Panda381/ATX80/www/img/atx80_5_m.jpg

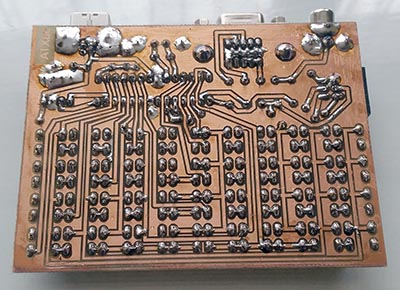
www/img/atx80_5_m.jpg
