Panda381/ATX80/www/img/atx80_8.jpg

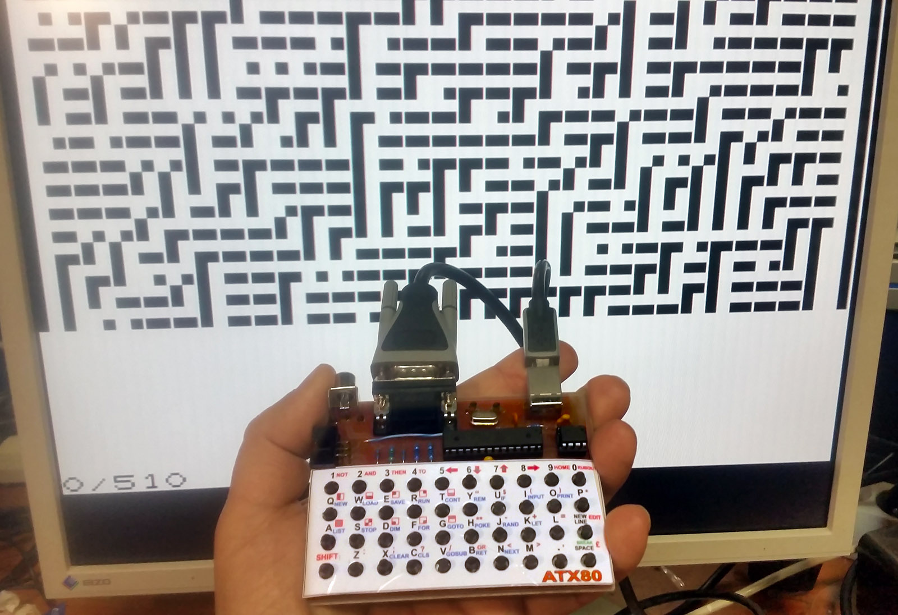
www/img/atx80_8.jpg
