Panda381/ATX80/png/ATX80_bottom.png

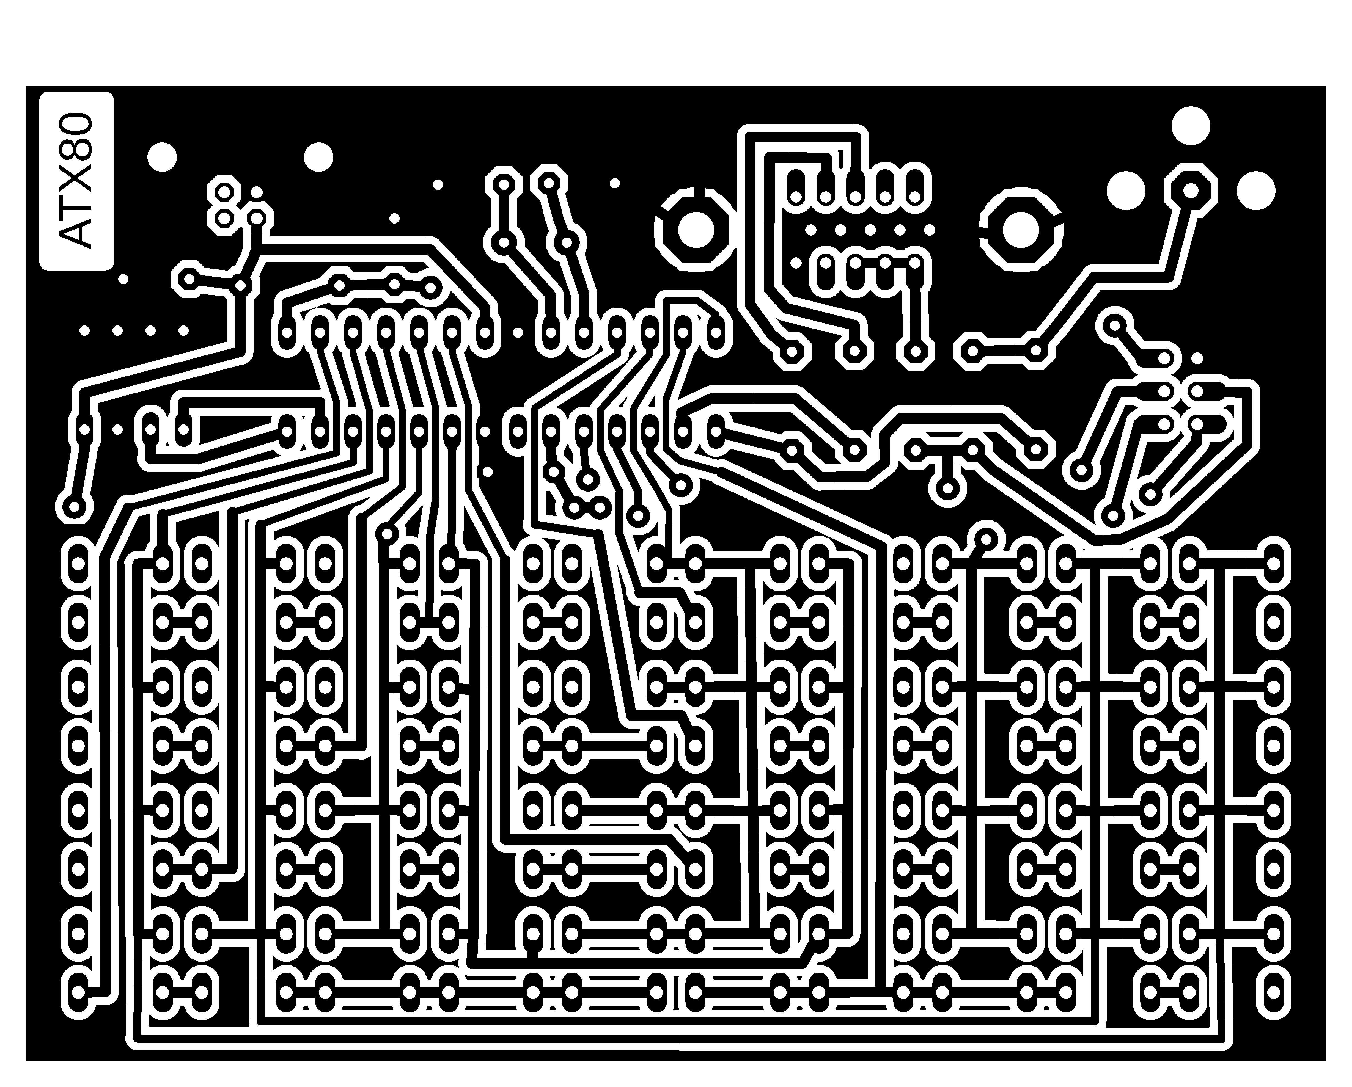
png/ATX80_bottom.png
