Panda381/ATX80/png/ATX80_diagram.png

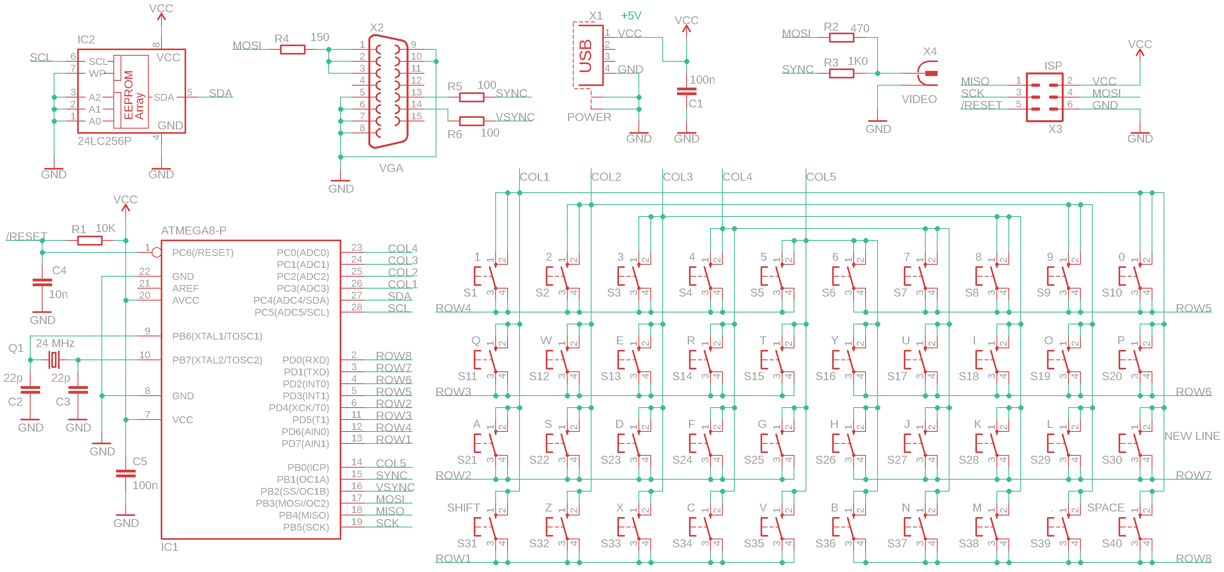
png/ATX80_diagram.png
