Panda381/ATX80/png/ATX80_doc.png

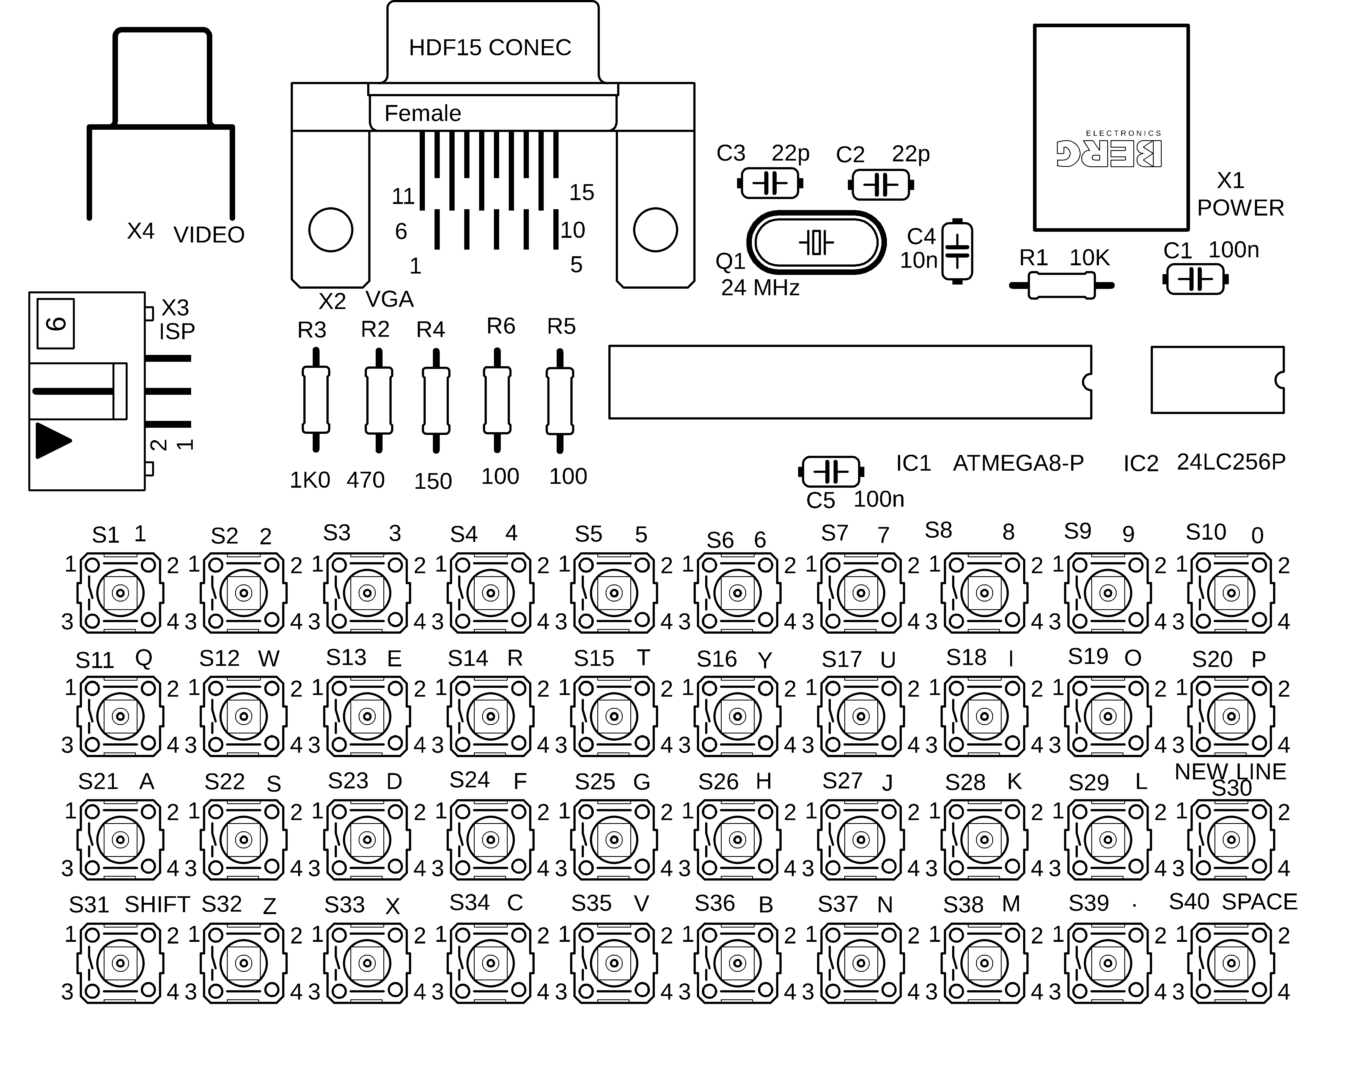
png/ATX80_doc.png
