Panda381/ATX80/png/ATX80_label.png

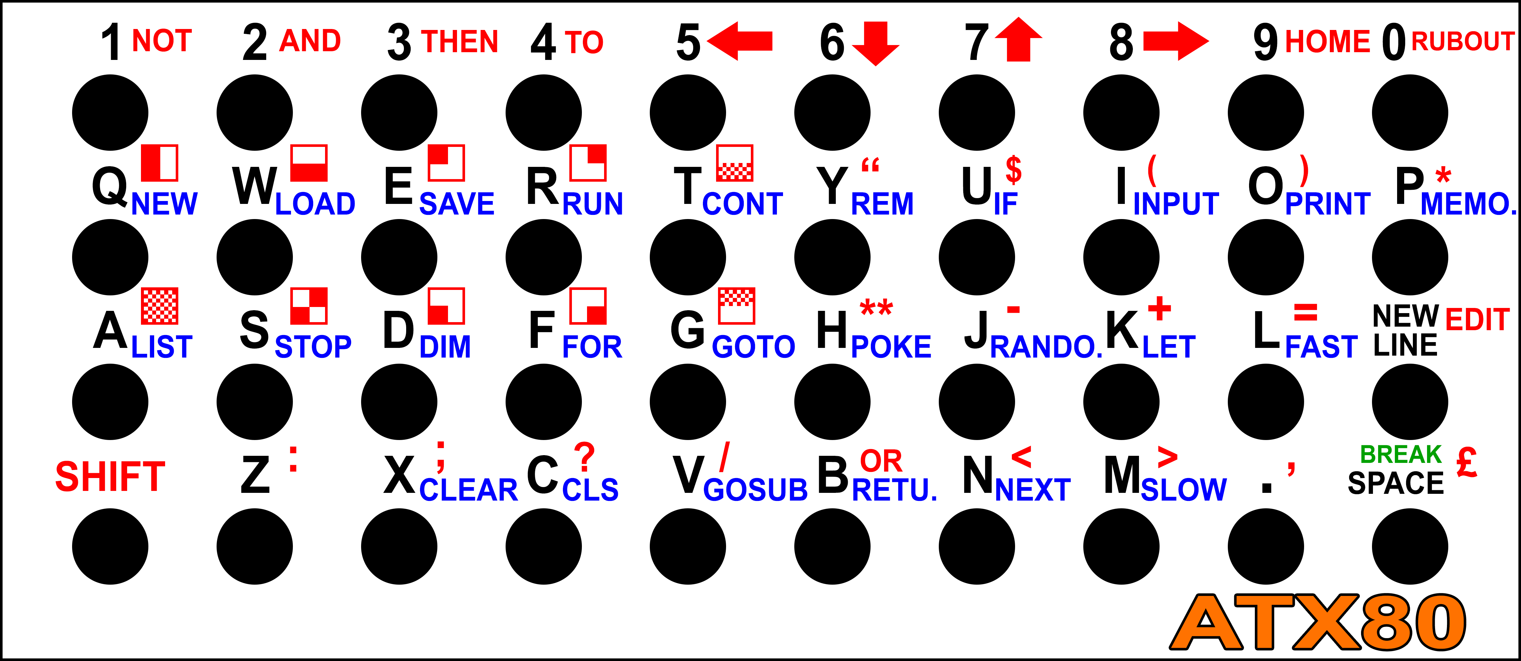
png/ATX80_label.png
