Panda381/ATX80/png/ATX80_mounte.jpg

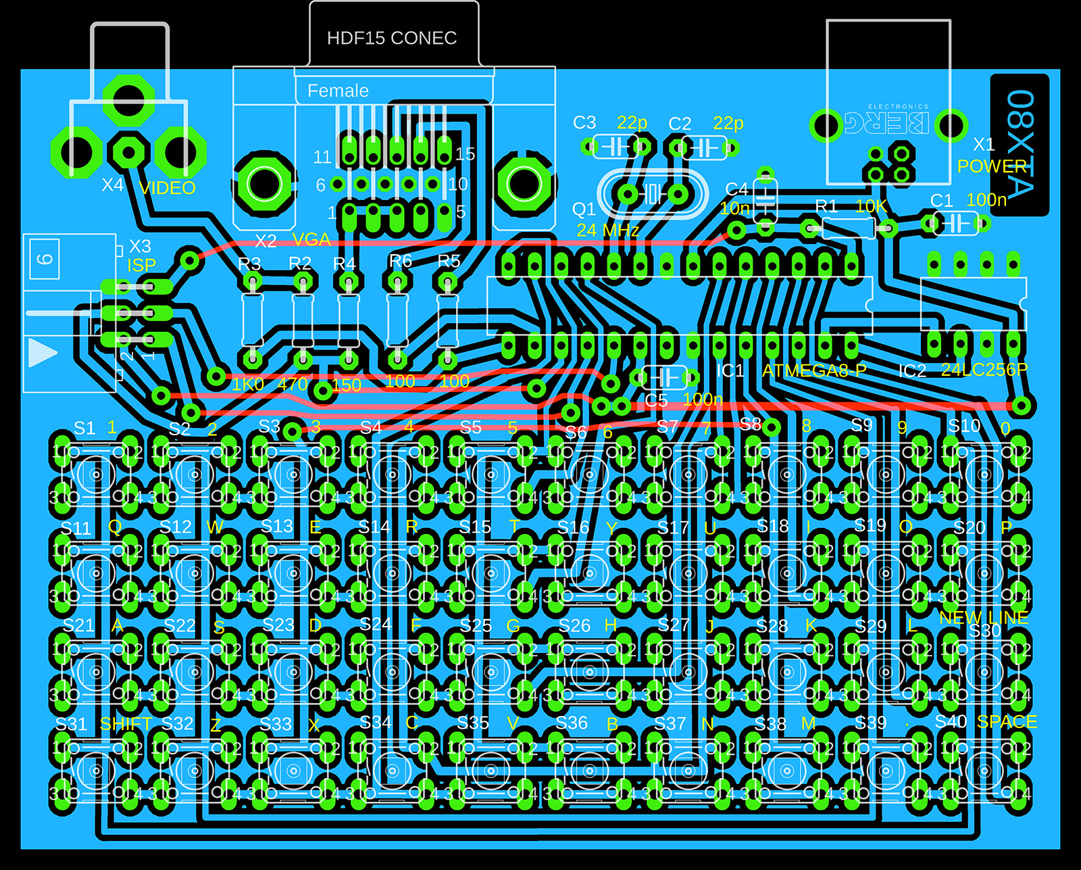
png/ATX80_mounte.jpg
