Panda381/ATX80/png/ATX80_names.png

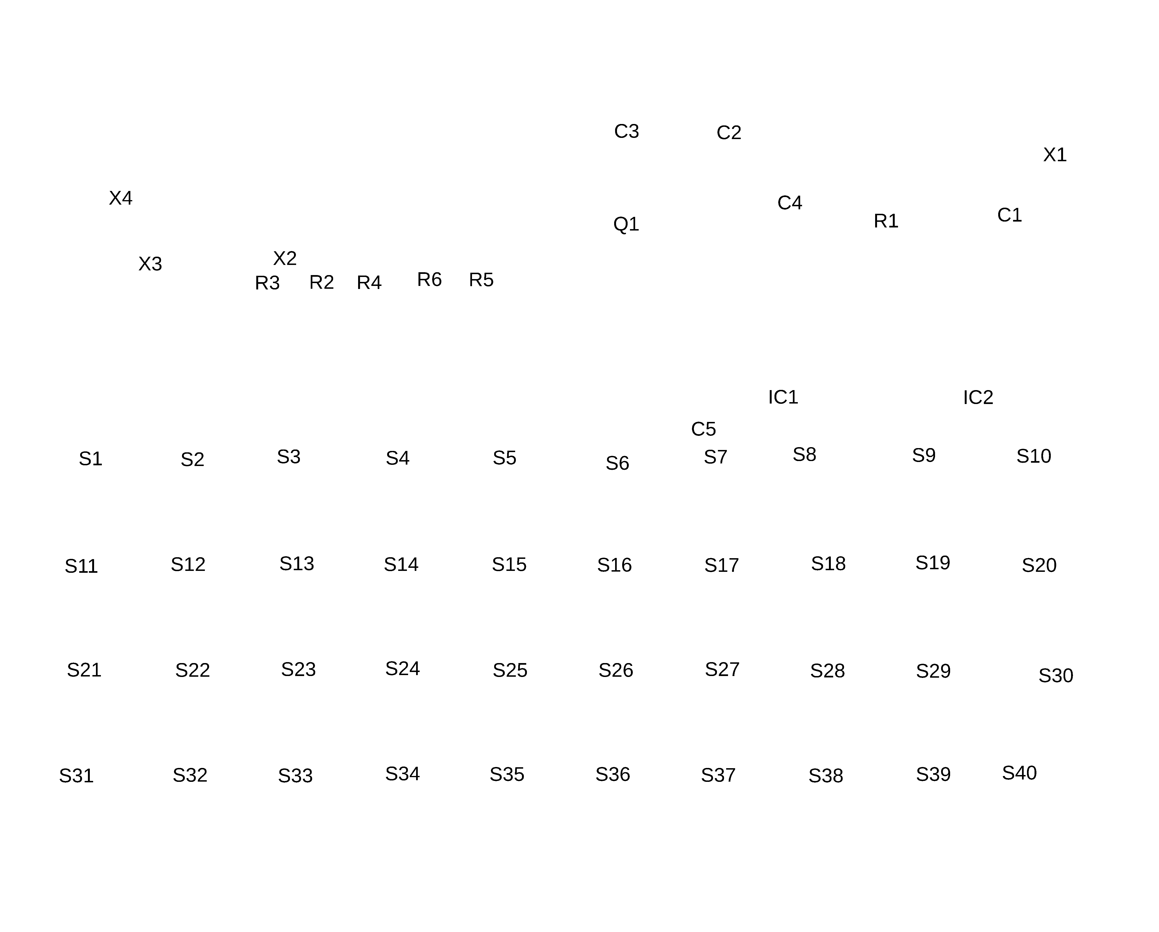
png/ATX80_names.png
