Panda381/ATX80/png/ATX80_pads.png

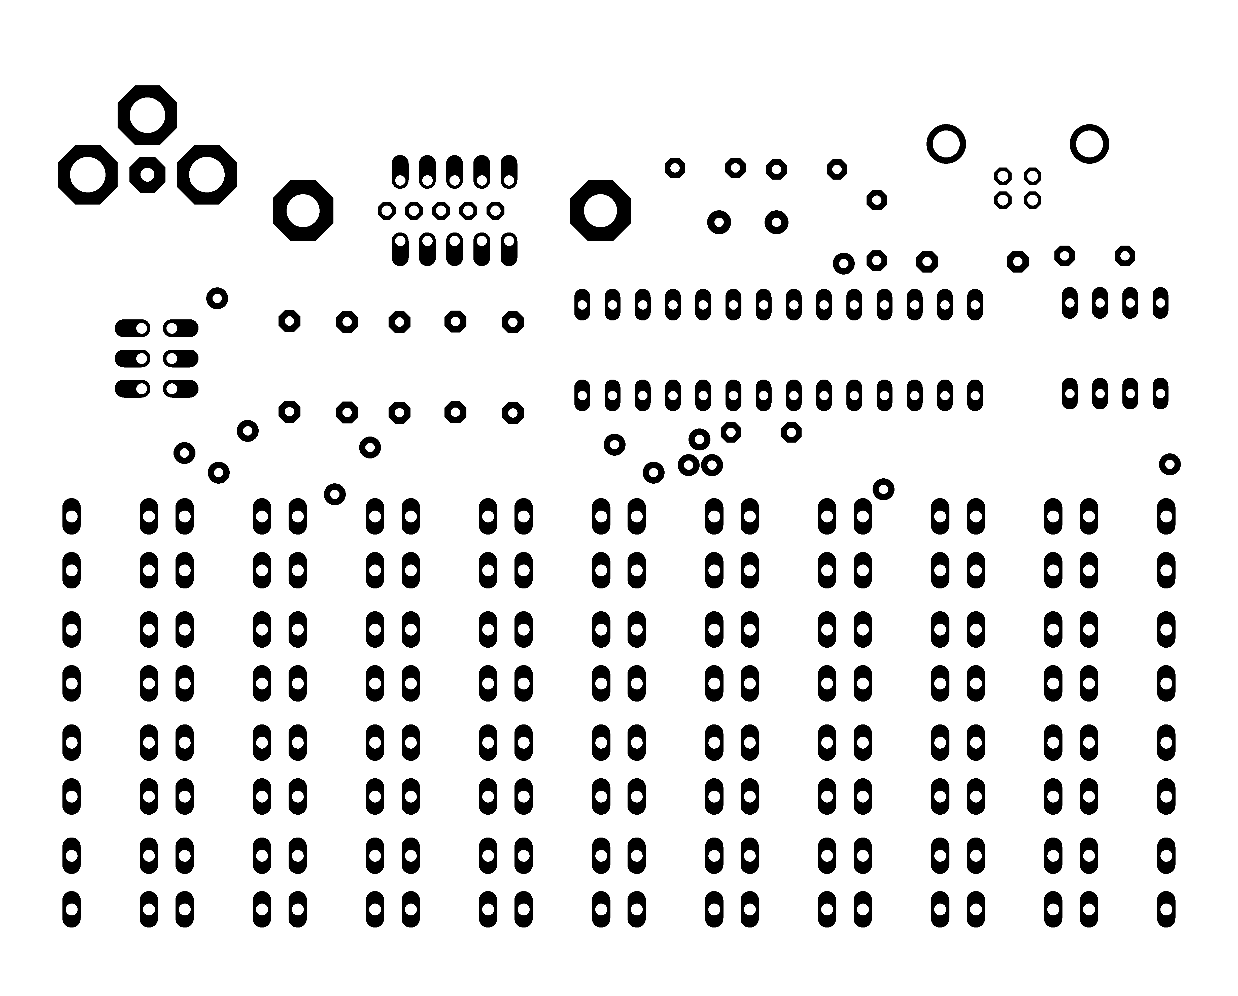
png/ATX80_pads.png
