Panda381/ATX80/png/ATX80_route.png

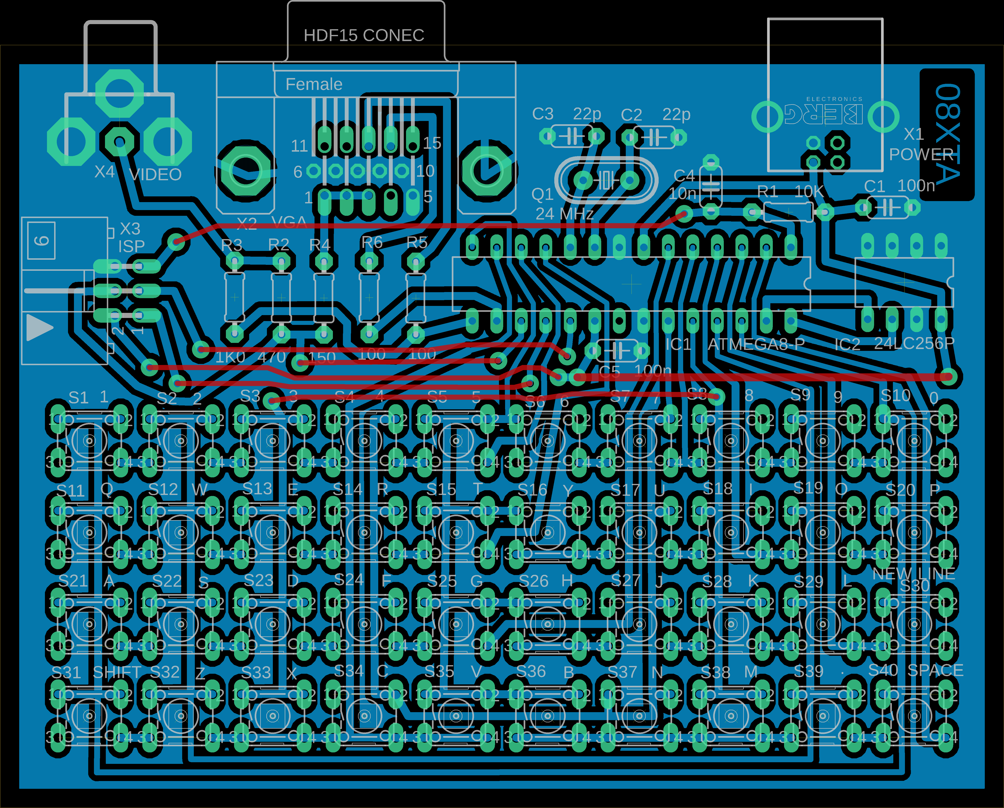
png/ATX80_route.png
