Panda381/ATX80/png/ATX80_template2.png

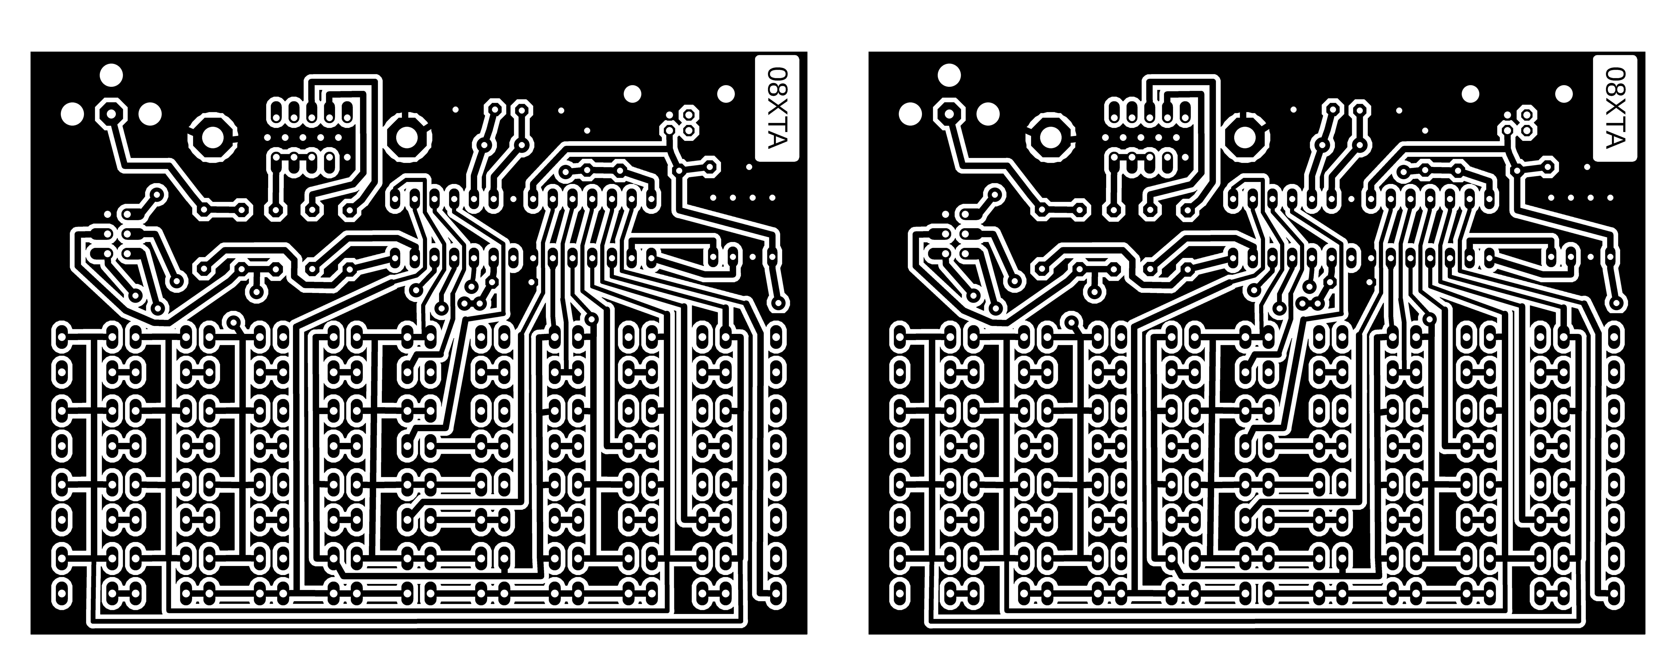
png/ATX80_template2.png
