Panda381/ATX80/png/ATX80_template.png

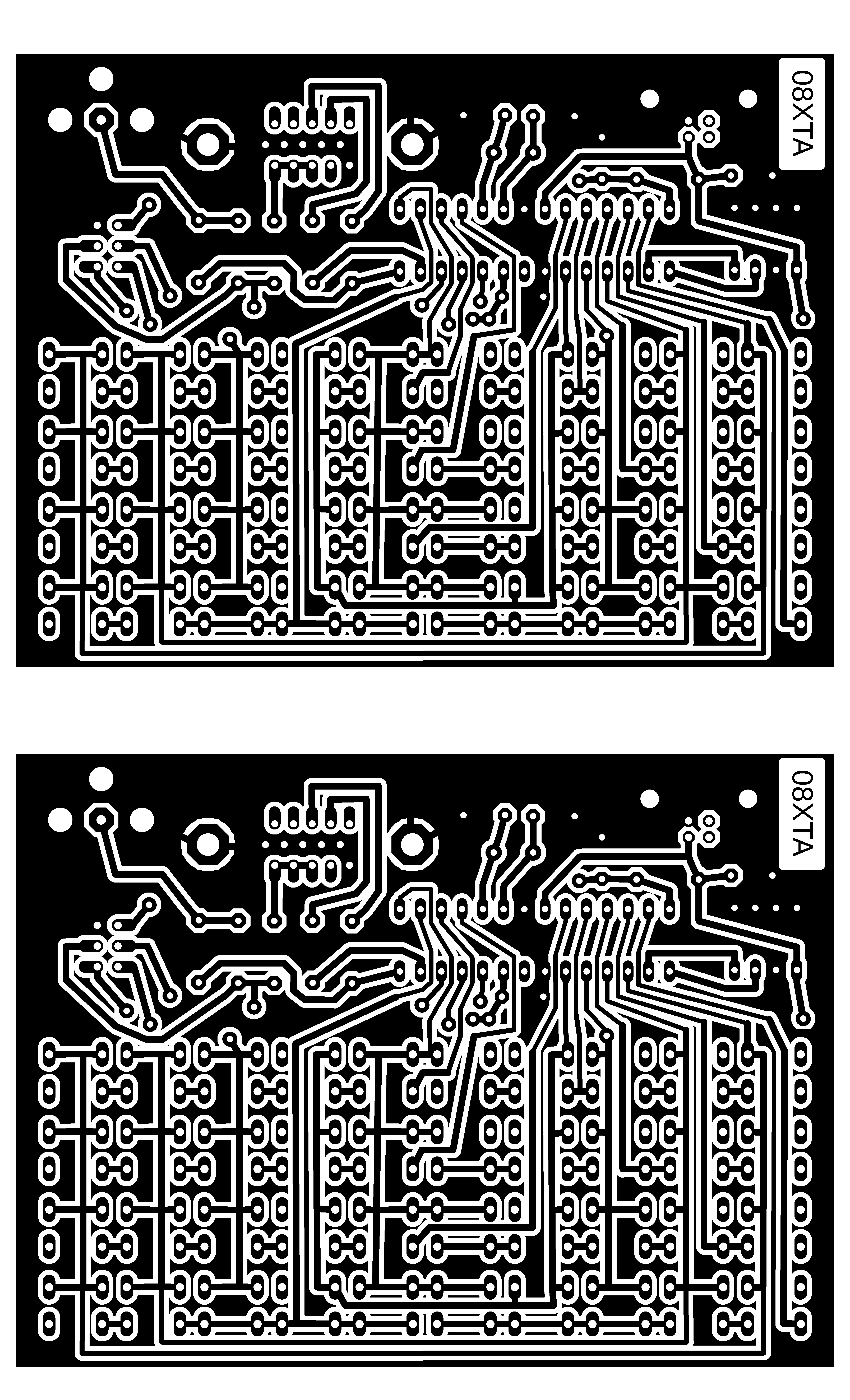
png/ATX80_template.png
