Panda381/ATX80/png/ATX80_top.png

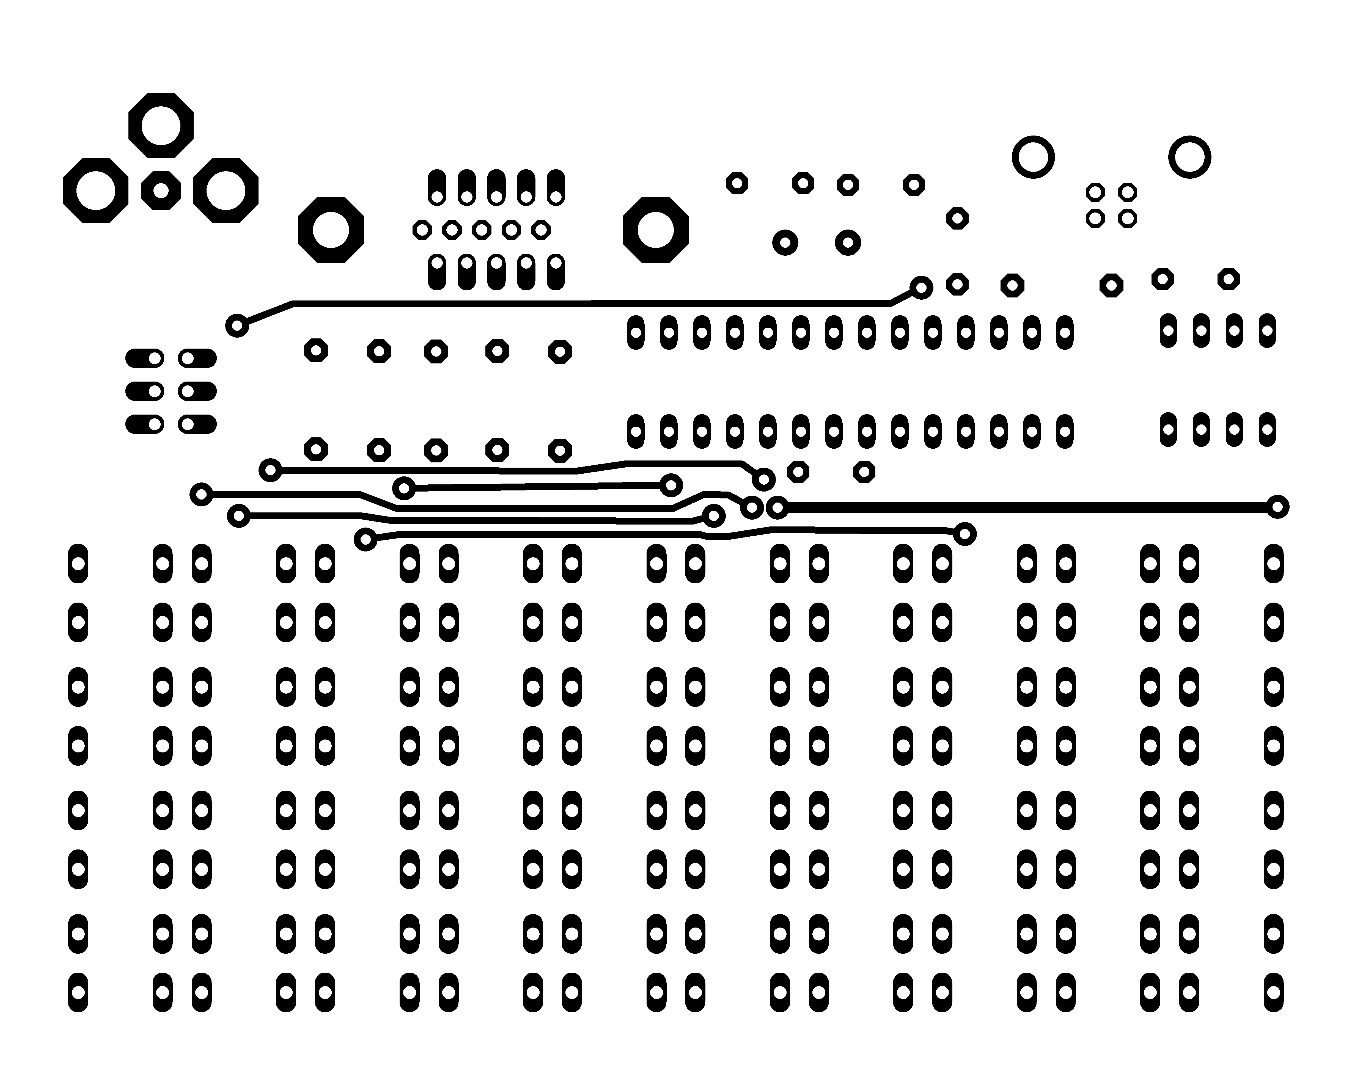
png/ATX80_top.png
