Panda381/ATX80/png/ATX80_values.png

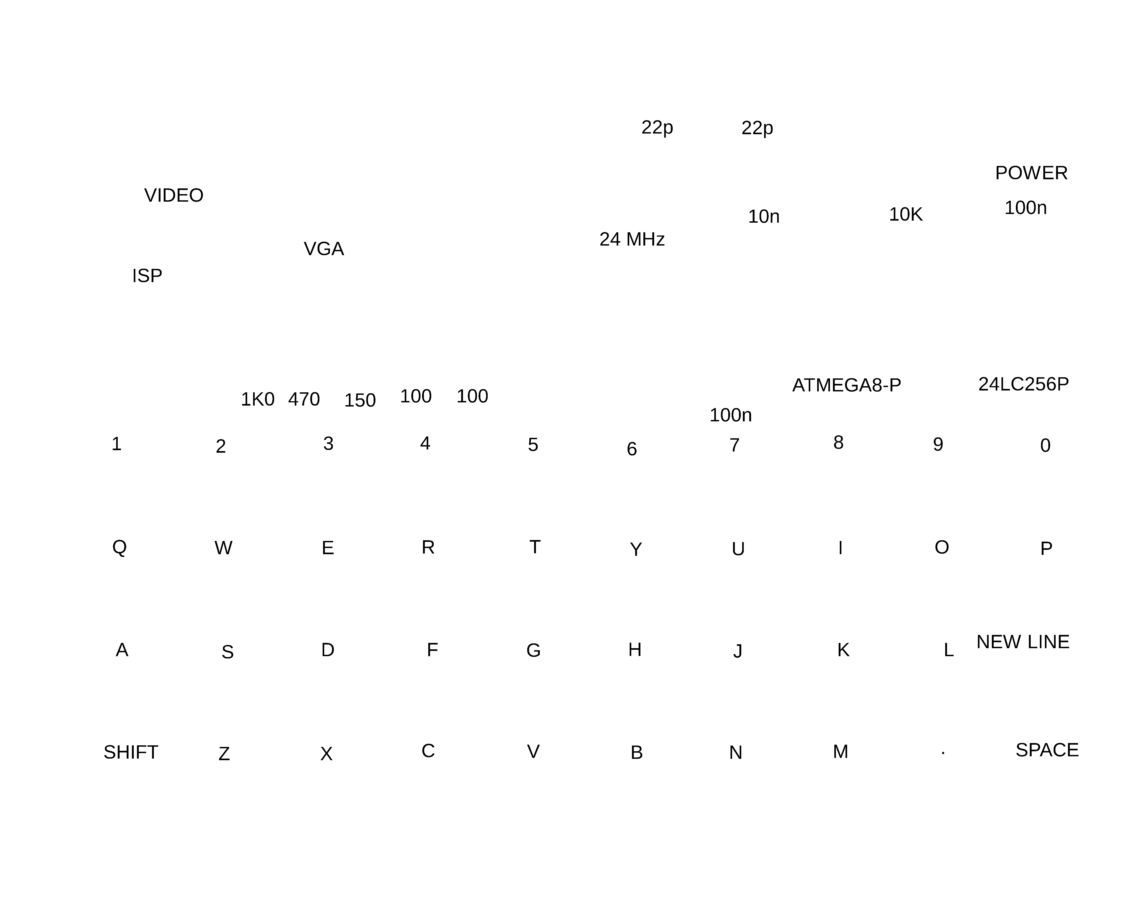
png/ATX80_values.png
