Panda381/ATX80/www/img/atx80_0_m.jpg

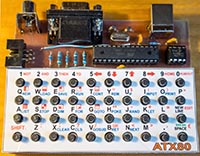
www/img/atx80_0_m.jpg
