Panda381/ATX80/www/img/atx80_2.jpg

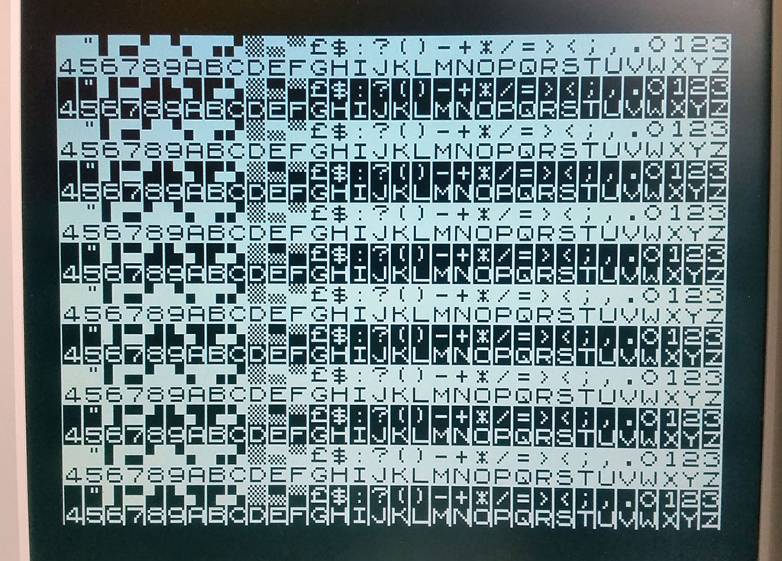
www/img/atx80_2.jpg
