Panda381/ATX80/www/img/atx80_3.jpg

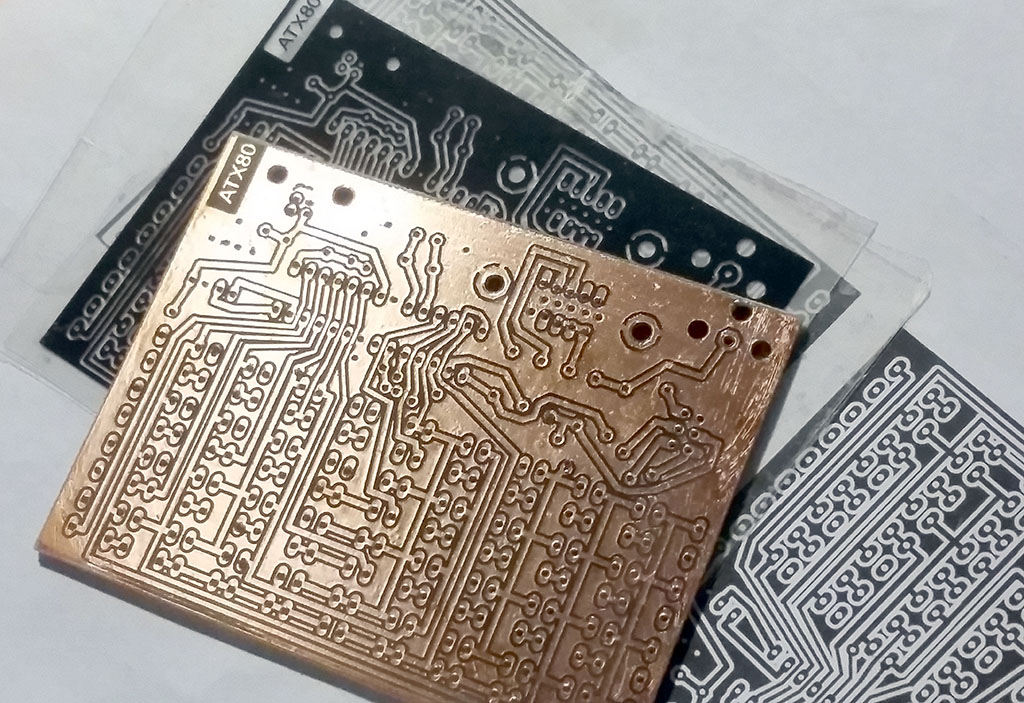
www/img/atx80_3.jpg
