Panda381/ATX80/www/img/atx80_4.jpg

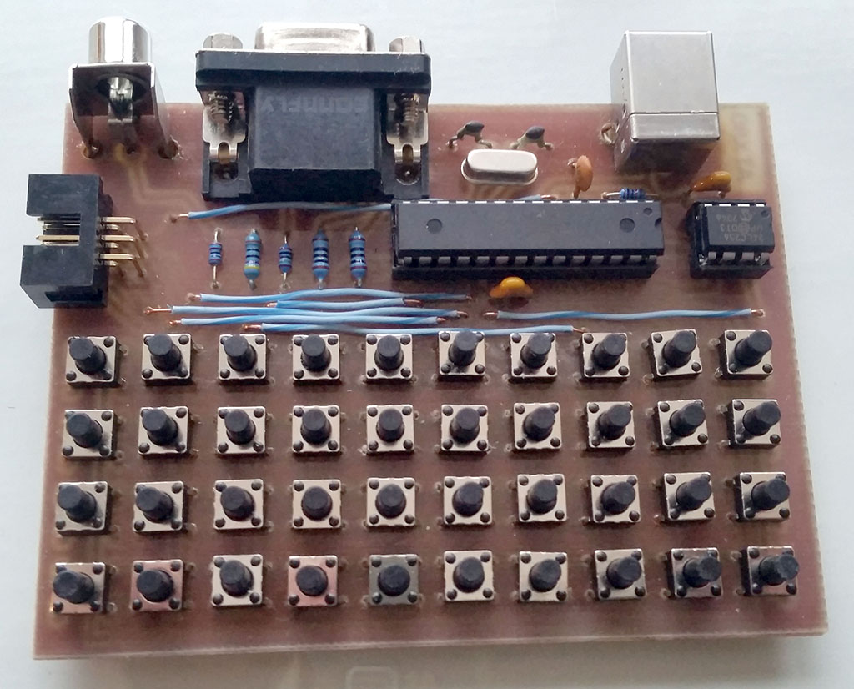
www/img/atx80_4.jpg
