Panda381/ATX80/www/img/atx80_6.jpg

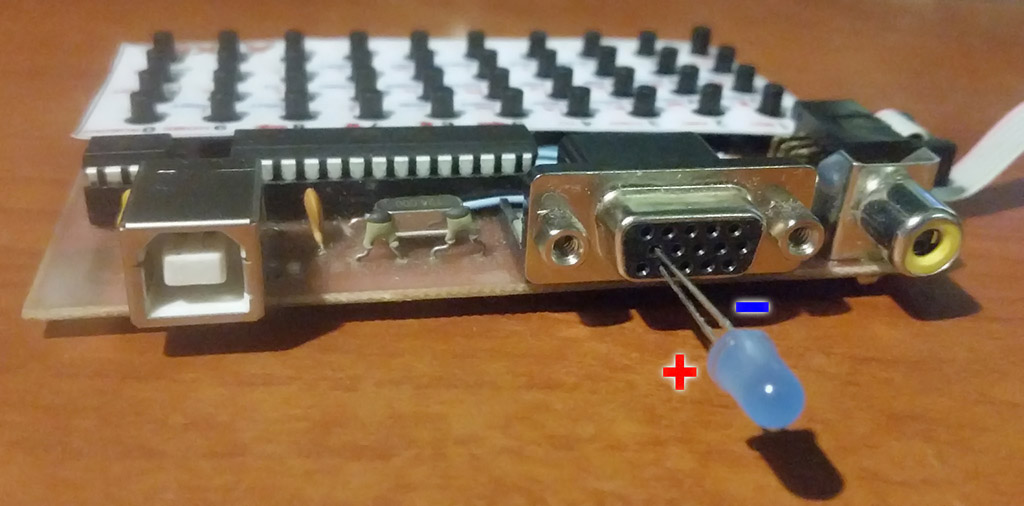
www/img/atx80_6.jpg
