Panda381/ATX80/www/img/atx80_7_m.jpg

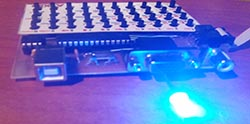
www/img/atx80_7_m.jpg
