Panda381/ATX80/www/img/ATX80_mounte_m.jpg

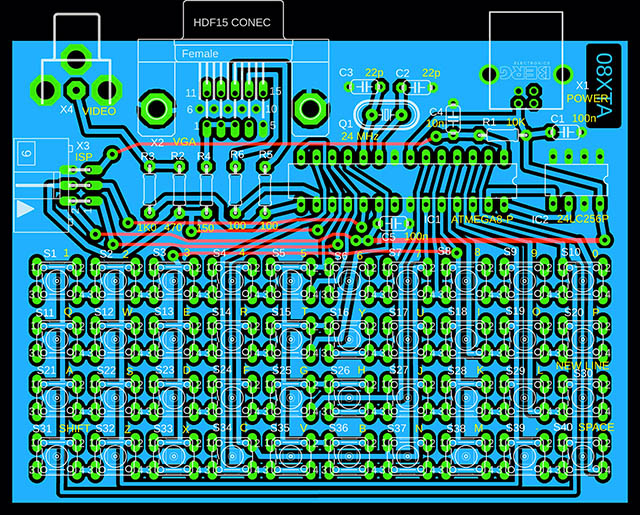
www/img/ATX80_mounte_m.jpg
