Panda381/ATX80/www/img/program_1.jpg

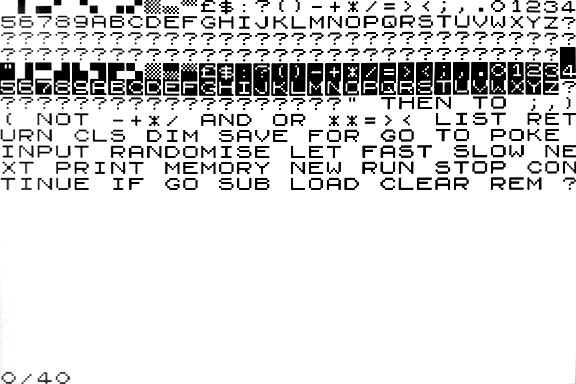
www/img/program_1.jpg
