Panda381/ATX80/www/img/program_2.jpg

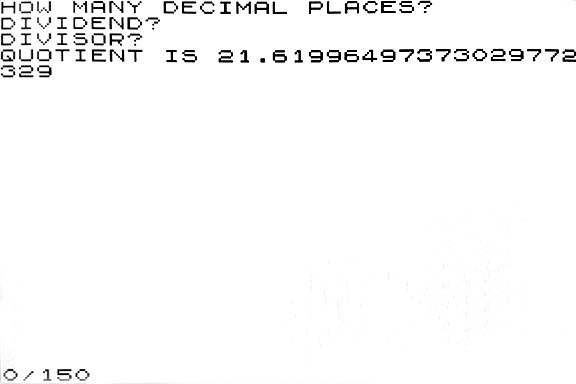
www/img/program_2.jpg
