Panda381/ATX80/www/img/program_3.jpg

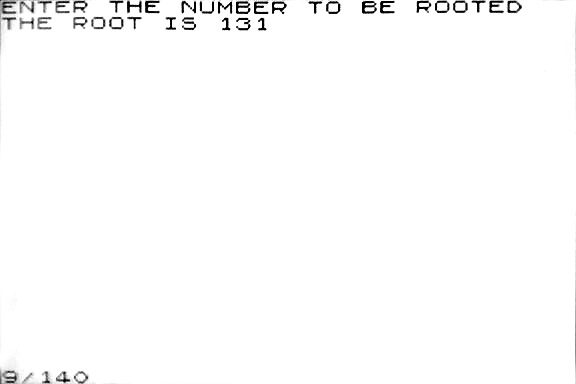
www/img/program_3.jpg
