Panda381/ATX80/www/img/program_4.jpg

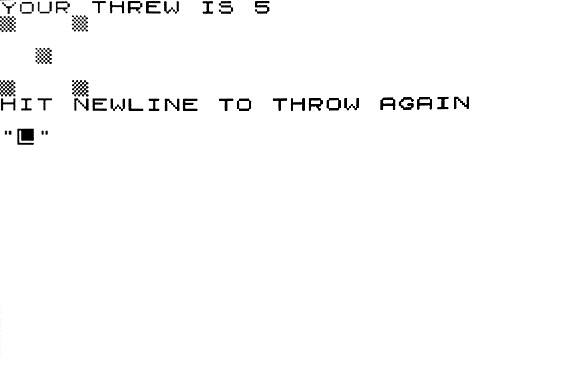
www/img/program_4.jpg
