Panda381/ATX80/www/img/program_5.jpg

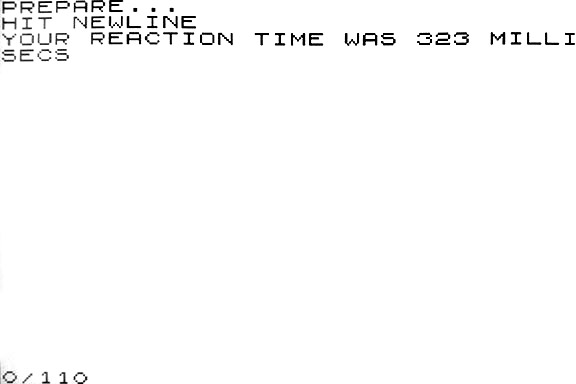
www/img/program_5.jpg
