Panda381/ATX80/www/img/program_6.jpg

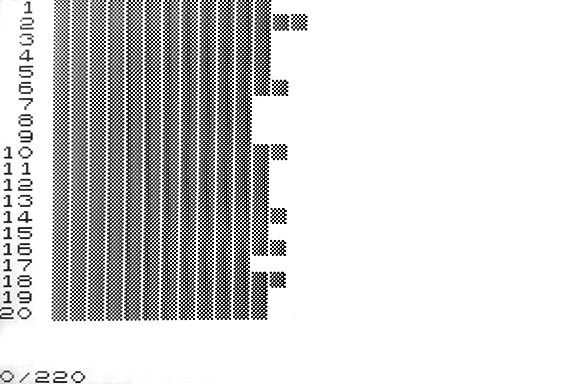
www/img/program_6.jpg
