Panda381/ATX80/www/img/program_7.jpg

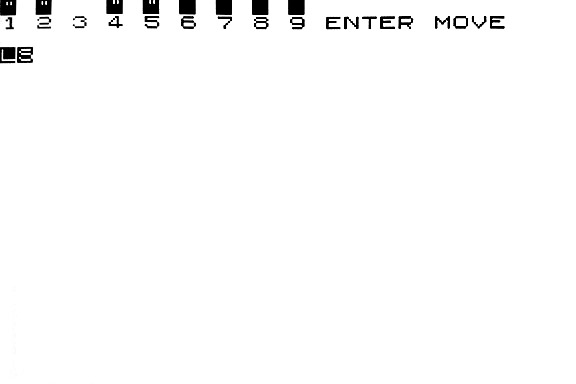
www/img/program_7.jpg
