Panda381/ATX80/www/img/program_8.jpg

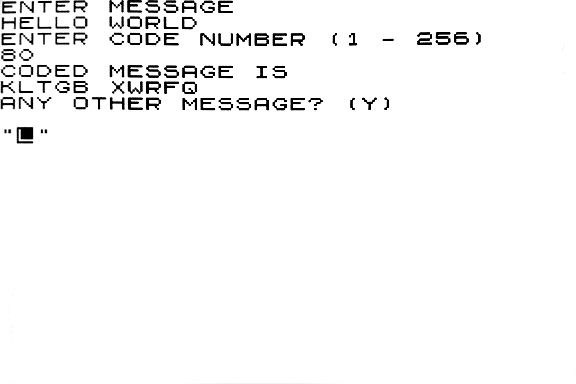
www/img/program_8.jpg
