Panda381/ATX80/www/img/program_9.jpg

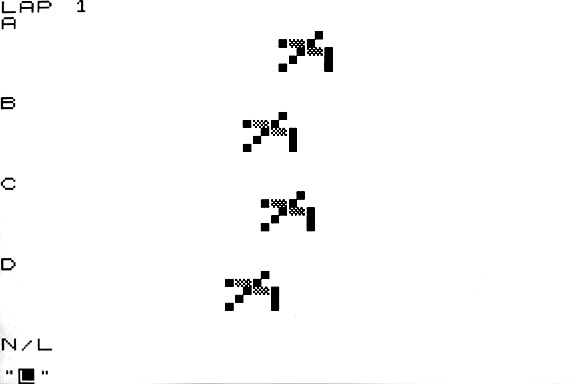
www/img/program_9.jpg
