Panda381/ATX80/www/img/program_10.jpg

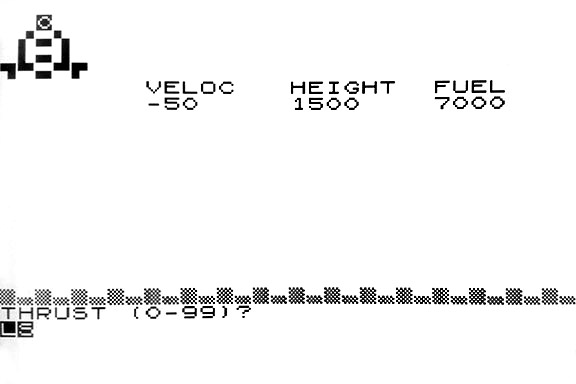
www/img/program_10.jpg
