Panda381/ATX80/www/img/program_11.jpg

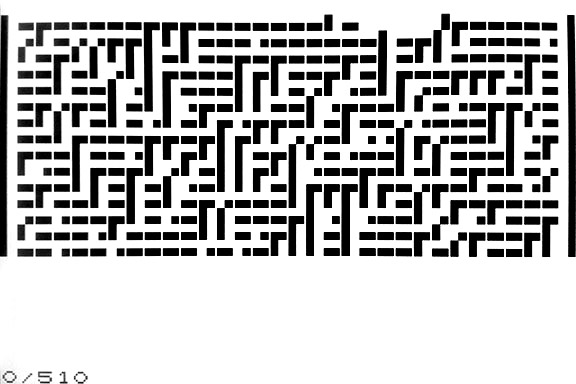
www/img/program_11.jpg
