Panda381/ATX80/www/img/program_12.jpg

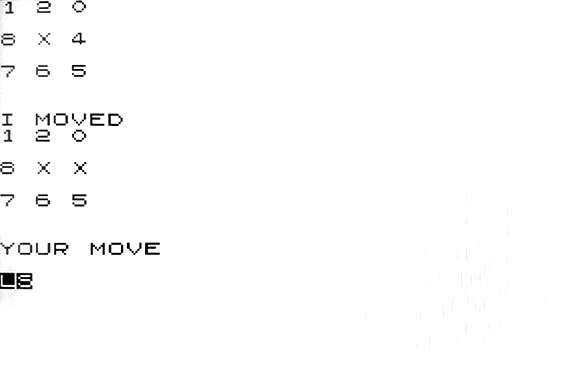
www/img/program_12.jpg
