Panda381/ATX80/www/img/program_13.jpg

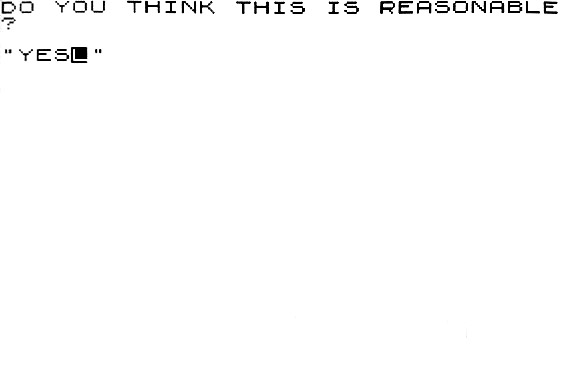
www/img/program_13.jpg
