Panda381/ATX80/www/img/program_14.jpg

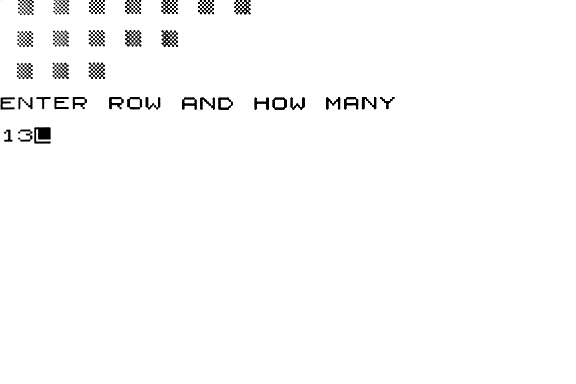
www/img/program_14.jpg
