Panda381/ATX80/www/img/program_15.jpg

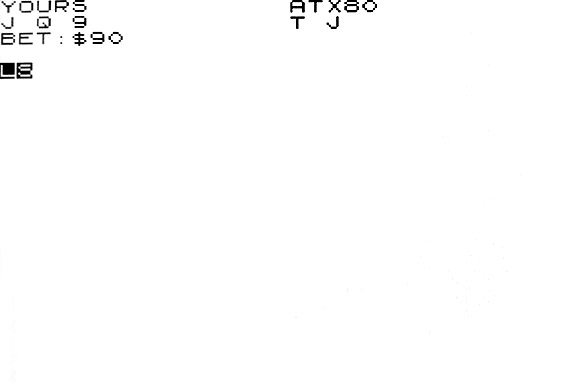
www/img/program_15.jpg
