Panda381/ATX80/www/img/program_16.jpg

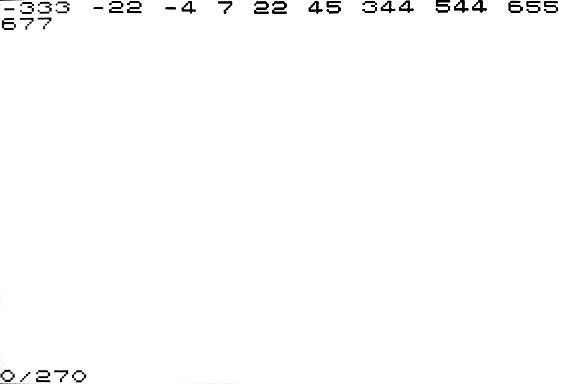
www/img/program_16.jpg
