Panda381/ATX80/www/img/program_17.jpg

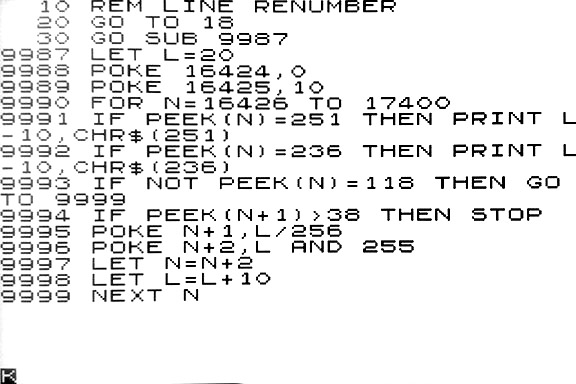
www/img/program_17.jpg
