Panda381/ATX80/www/img/program_18.jpg

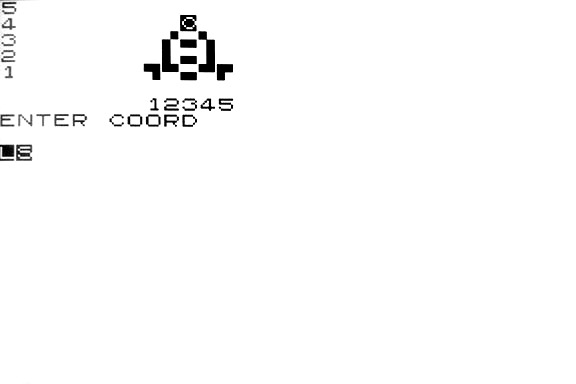
www/img/program_18.jpg
