Panda381/ATX80/www/img/program_19.jpg

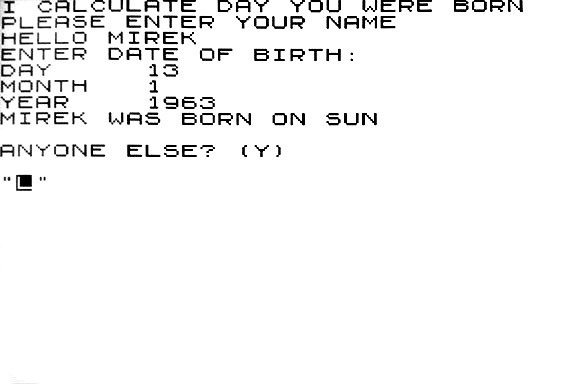
www/img/program_19.jpg
