Panda381/ATX80/www/img/program_20.jpg

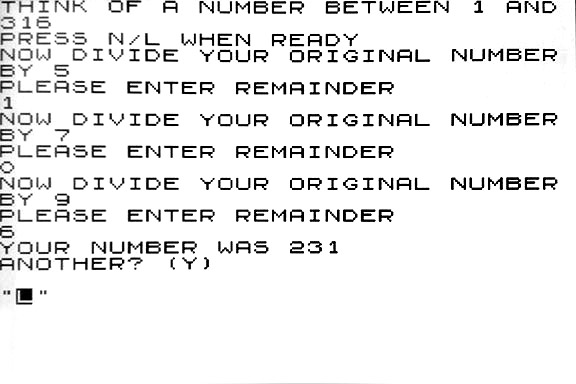
www/img/program_20.jpg
