Panda381/ATX80/www/img/program_21.jpg

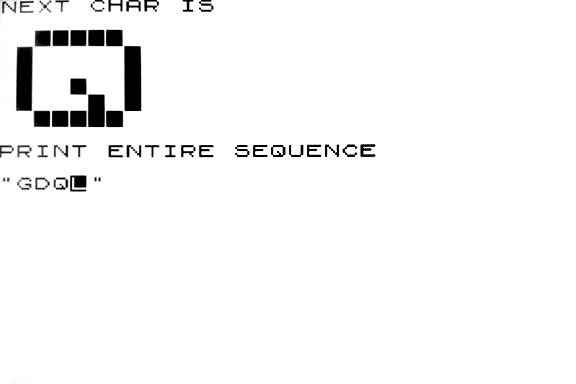
www/img/program_21.jpg
