Panda381/ATX80/www/img/program_22.jpg

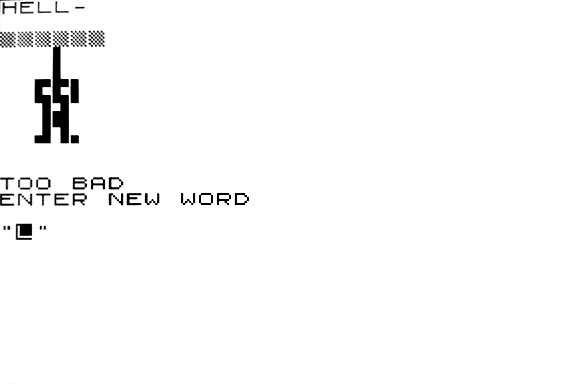
www/img/program_22.jpg
