Panda381/ATX80/www/img/program_23.jpg

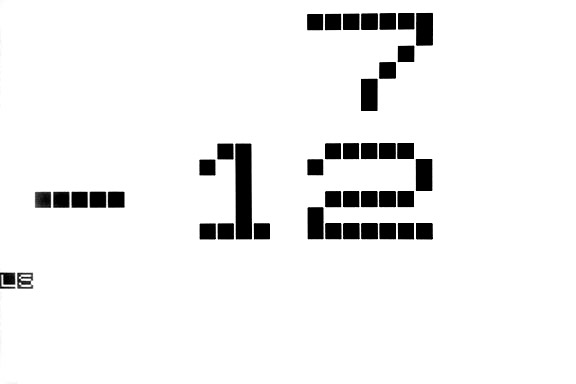
www/img/program_23.jpg
