Panda381/ATX80/www/img/program_24.jpg

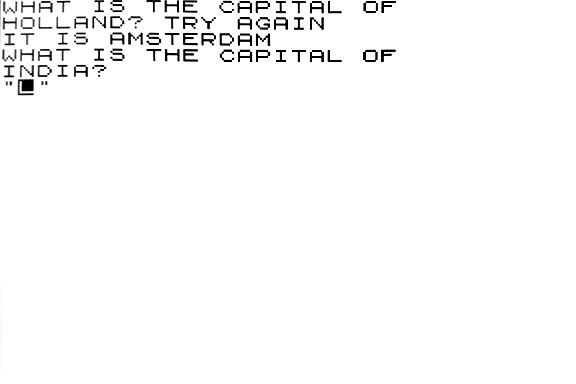
www/img/program_24.jpg
