Panda381/ATX80/www/img/program_25.jpg

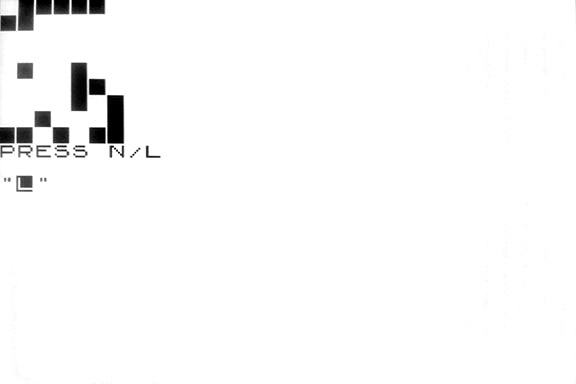
www/img/program_25.jpg
