Panda381/ATX80/www/img/program_26.jpg

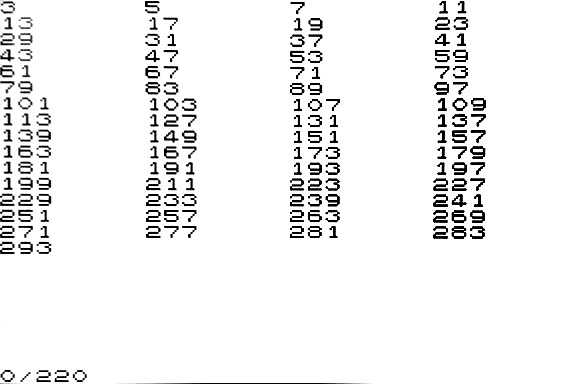
www/img/program_26.jpg
