Panda381/ATX80/www/img/program_27.jpg

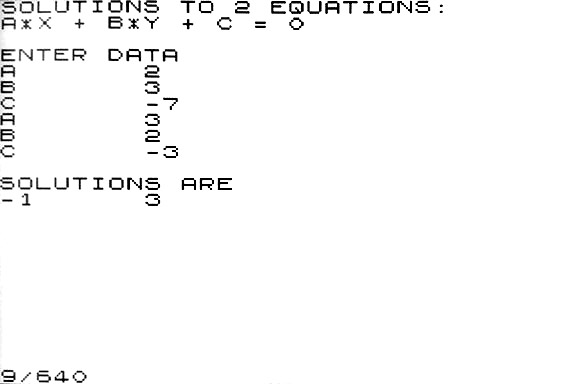
www/img/program_27.jpg
