Panda381/ATX80/www/img/program_28.jpg

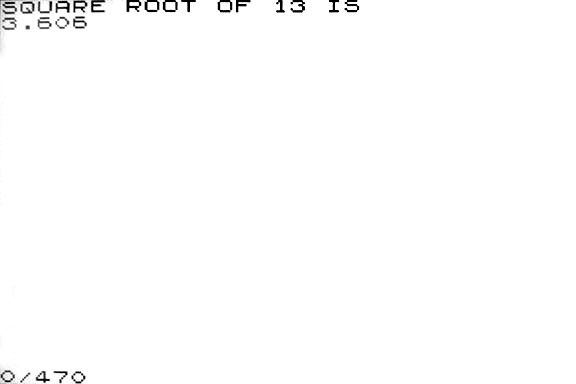
www/img/program_28.jpg
