Panda381/ATX80/www/img/program_29.jpg

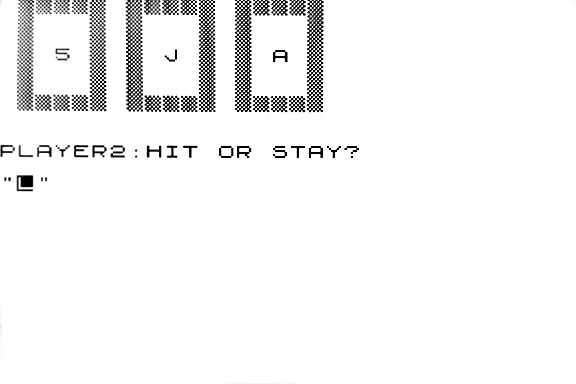
www/img/program_29.jpg
