Panda381/ATX80/www/img/program_30.jpg

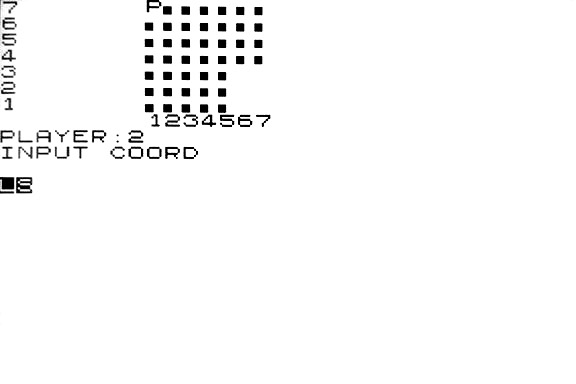
www/img/program_30.jpg
