Panda381/ATX80/www/img/program_31.jpg

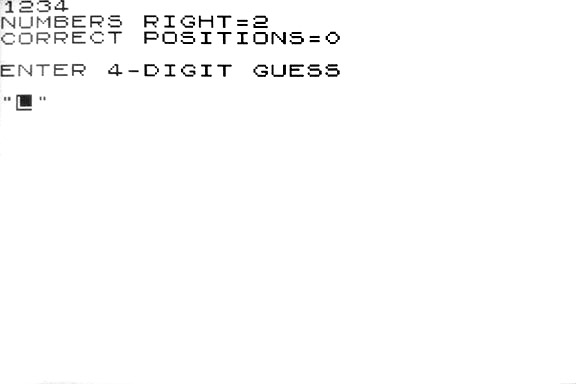
www/img/program_31.jpg
