Panda381/ATX80/www/img/program_32.jpg

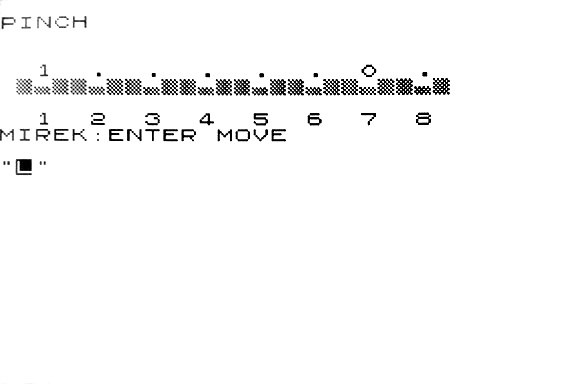
www/img/program_32.jpg
