Panda381/ATX80/www/img/ATX80_print_m.jpg

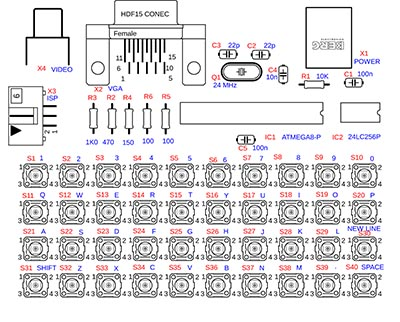
www/img/ATX80_print_m.jpg
