Panda381/ATX80/(threads)

Thread 1 (2024-05-13):

increasing RAM to 2k

robert-rozee, 2024-05-13:
hi,
    this is a very neat project!

if using an atmega328p processor (2k RAM, 32k flash) how difficult would it be to increase the usable RAM setting from the current 1k limit to instead be 2k? and, at the same time, change the program slot sizes for the external eeprom to 2k as well?

i'm rather hoping it may be possible with just be a couple of patches to the pre-built ATX80_328.hex file.

cheers,
rob   :-)

Panda381, 2024-05-13:
I assume the ATmega328 processor uses more memory, but I'm not sure - it's been many years and I don't remember much of it. And I wouldn't even see it promising to develop this project further. It was more just a study, but it has drawbacks - it doesn't allow to emulate Z80 code and therefore many Z80 programs don't work. Nowadays I would rather solve this with Raspberry Pico - I plan to implement this emulation in the Picopad project, too.

robert-rozee, 2024-05-13:
the ATX80 has an elegance of design that the pico does not quite capture, hence my interest in it. and i don't really see the lack of Z80 code access as detracting from it.

yes, the major difference going from atmega8 to atmega328 is the amount of RAM (1k -> 2k) and flash (8k -> 32k). i'll have a dig through your source and see if i can find out where the RAM size is set.

fyi, you may like to have a look at mmbasic for the pico. see:
[https://geoffg.net/picomite.html](url)
[https://geoffg.net/picomitevga.html](url)
with source here:
[https://github.com/UKTailwind/PicoMite](url)
and a user community here:
[https://www.thebackshed.com/forum/ViewForum.php?FID=16](url)
mmbasic also runs on the 28-pin DIP pic32mx170:
[https://geoffg.net/MicromiteMX170.html](url)

cheers,
rob   :-)

Panda381, 2024-05-13:
The processor definitions are in the include.inc file. Differences for ATmega328 are set here, such as larger RAM - they are taken from the processor definition in the compiler (e.g. E2END specifies the EEPROM size). The ATX80 uses larger memory in the case of the ATmega328.

Yes I know PicoMite, it uses my PicoVGA display driver.

robert-rozee, 2024-05-20:
> The ATX80 uses larger memory in the case of the ATmega328.

excellent, although i do see that in boot.S lines 208-209 have the number 950 hard-coded, while lines 236-236 have 951 hard-coded. hopefully these are just limits on the maximum size of the program recovered after a reboot.

i'm interested enough to have ordered a pack of 50x push buttons from ebay, and upon their arrival (on a slow boat from china) will build up a complete atx80. how close did the atx81 come to being complete? it would be neat to also have access to other I2C devices such as the MCP23017 through the use of PEEK and POKE instructions to a buffer!

cheers,
rob   :-)
