Panda381/ATX80/diagram/ATX80.brd

## EAGLE design diagram/ATX80.brd (2021-12-15)

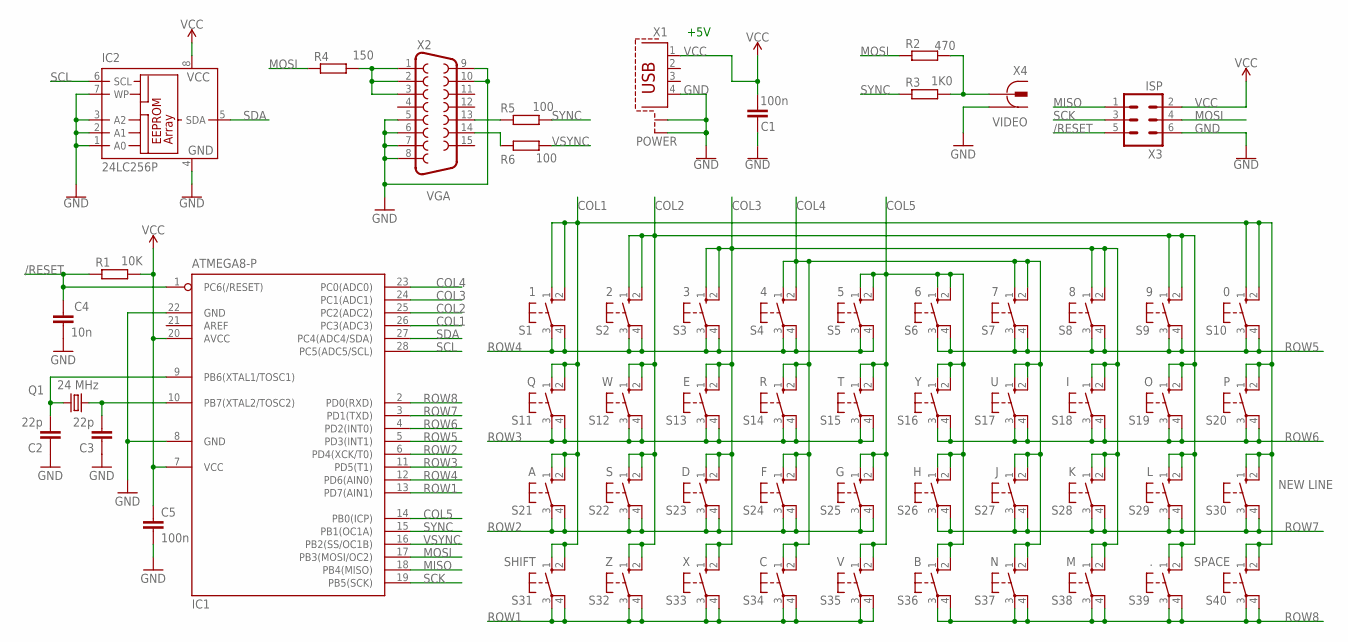
[picture p55: schematic ATX80.sch]

Parts:
C1, C5: 100n; C050-024X044
C2, C3: 22p; C050-024X044
C4: 10n; C050-024X044
IC1: ATMEGA8-P; DIL28-3
IC2: 24LC256P; DIL8
Q1: 24 MHz; HC49U-V
R1: 10K; 0204/7
R2: 470; 0204/7
R3: 1K0; 0204/7
R4: 150; 0204/7
R5, R6: 100; 0204/7
S1: 1; B3F-10XX
S2: 2; B3F-10XX
S3: 3; B3F-10XX
S4: 4; B3F-10XX
S5: 5; B3F-10XX
S6: 6; B3F-10XX
S7: 7; B3F-10XX
S8: 8; B3F-10XX
S9: 9; B3F-10XX
S10: 0; B3F-10XX
S11: Q; B3F-10XX
S12: W; B3F-10XX
S13: E; B3F-10XX
S14: R; B3F-10XX
S15: T; B3F-10XX
S16: Y; B3F-10XX
S17: U; B3F-10XX
S18: I; B3F-10XX
S19: O; B3F-10XX
S20: P; B3F-10XX
S21: A; B3F-10XX
S22: S; B3F-10XX
S23: D; B3F-10XX
S24: F; B3F-10XX
S25: G; B3F-10XX
S26: H; B3F-10XX
S27: J; B3F-10XX
S28: K; B3F-10XX
S29: L; B3F-10XX
S30: NEW LINE; B3F-10XX
S31: SHIFT; B3F-10XX
S32: Z; B3F-10XX
S33: X; B3F-10XX
S34: C; B3F-10XX
S35: V; B3F-10XX
S36: B; B3F-10XX
S37: N; B3F-10XX
S38: M; B3F-10XX
S39: .; B3F-10XX
S40: SPACE; B3F-10XX
X1: POWER; PN61729-S
X2: VGA; HDF15H
X3: ISP; ML6L
X4: VIDEO; 736880-49

Connections:
/RESET: C4.1, IC1.1 (PC6(/RESET)), R1.1, X3.5
COL1: IC1.26 (PC3(ADC3)), S1.1 (S), S1.2 (S1), S10.1 (S), S10.2 (S1), S11.1 (S), S11.2 (S1), S20.1 (S), S20.2 (S1), S21.1 (S), S21.2 (S1), S30.1 (S), S30.2 (S1), S31.1 (S), S31.2 (S1), S40.1 (S), S40.2 (S1)
COL2: IC1.25 (PC2(ADC2)), S2.1 (S), S2.2 (S1), S9.1 (S), S9.2 (S1), S12.1 (S), S12.2 (S1), S19.1 (S), S19.2 (S1), S22.1 (S), S22.2 (S1), S29.1 (S), S29.2 (S1), S32.1 (S), S32.2 (S1), S39.1 (S), S39.2 (S1)
COL3: IC1.24 (PC1(ADC1)), S3.1 (S), S3.2 (S1), S8.1 (S), S8.2 (S1), S13.1 (S), S13.2 (S1), S18.1 (S), S18.2 (S1), S23.1 (S), S23.2 (S1), S28.1 (S), S28.2 (S1), S33.1 (S), S33.2 (S1), S38.1 (S), S38.2 (S1)
COL4: IC1.23 (PC0(ADC0)), S4.1 (S), S4.2 (S1), S7.1 (S), S7.2 (S1), S14.1 (S), S14.2 (S1), S17.1 (S), S17.2 (S1), S24.1 (S), S24.2 (S1), S27.1 (S), S27.2 (S1), S34.1 (S), S34.2 (S1), S37.1 (S), S37.2 (S1)
COL5: IC1.14 (PB0(ICP)), S5.1 (S), S5.2 (S1), S6.1 (S), S6.2 (S1), S15.1 (S), S15.2 (S1), S16.1 (S), S16.2 (S1), S25.1 (S), S25.2 (S1), S26.1 (S), S26.2 (S1), S35.1 (S), S35.2 (S1), S36.1 (S), S36.2 (S1)
GND: C1.1, C2.1, C3.1, C4.2, C5.2, IC1.8 (GND), IC1.22 (GND), IC2.1 (A0), IC2.2 (A1), IC2.3 (A2), IC2.4 (GND), IC2.7 (WP), X1.4, X1.S1, X1.S2, X2.5, X2.6, X2.7, X2.8, X2.9, X2.10, X3.6, X4.1, X4.1@1 (1), X4.1@2 (1)
MISO: IC1.18 (PB4(MISO)), X3.1
MOSI: IC1.17 (PB3(MOSI/OC2)), R2.1, R4.1, X3.4
unnamed: R6.1, X2.14
unnamed: R5.1, X2.13
unnamed: R4.2, X2.1, X2.2, X2.3
unnamed: C2.2, IC1.9 (PB6(XTAL1/TOSC1)), Q1.2
unnamed: C3.2, IC1.10 (PB7(XTAL2/TOSC2)), Q1.1
unnamed: R2.2, R3.2, X4.2
ROW1: IC1.13 (PD7(AIN1)), S31.3, S31.4 (P1), S32.3, S32.4 (P1), S33.3, S33.4 (P1), S34.3, S34.4 (P1), S35.3, S35.4 (P1)
ROW2: IC1.6 (PD4(XCK/T0)), S21.3, S21.4 (P1), S22.3, S22.4 (P1), S23.3, S23.4 (P1), S24.3, S24.4 (P1), S25.3, S25.4 (P1)
ROW3: IC1.11 (PD5(T1)), S11.3, S11.4 (P1), S12.3, S12.4 (P1), S13.3, S13.4 (P1), S14.3, S14.4 (P1), S15.3, S15.4 (P1)
ROW4: IC1.12 (PD6(AIN0)), S1.3, S1.4 (P1), S2.3, S2.4 (P1), S3.3, S3.4 (P1), S4.3, S4.4 (P1), S5.3, S5.4 (P1)
ROW5: IC1.5 (PD3(INT1)), S6.3, S6.4 (P1), S7.3, S7.4 (P1), S8.3, S8.4 (P1), S9.3, S9.4 (P1), S10.3, S10.4 (P1)
ROW6: IC1.4 (PD2(INT0)), S16.3, S16.4 (P1), S17.3, S17.4 (P1), S18.3, S18.4 (P1), S19.3, S19.4 (P1), S20.3, S20.4 (P1)
ROW7: IC1.3 (PD1(TXD)), S26.3, S26.4 (P1), S27.3, S27.4 (P1), S28.3, S28.4 (P1), S29.3, S29.4 (P1), S30.3, S30.4 (P1)
ROW8: IC1.2 (PD0(RXD)), S36.3, S36.4 (P1), S37.3, S37.4 (P1), S38.3, S38.4 (P1), S39.3, S39.4 (P1), S40.3, S40.4 (P1)
SCK: IC1.19 (PB5(SCK)), X3.3
SCL: IC1.28 (PC5(ADC5/SCL)), IC2.6 (SCL)
SDA: IC1.27 (PC4(ADC4/SDA)), IC2.5 (SDA)
SYNC: IC1.15 (PB1(OC1A)), R3.1, R5.2
VCC: C1.2, C5.1, IC1.7 (VCC), IC1.20 (AVCC), IC2.8 (VCC), R1.2, X1.1, X3.2
VSYNC: IC1.16 (PB2(SS/OC1B)), R6.2

Notes on the sheet:
+5V

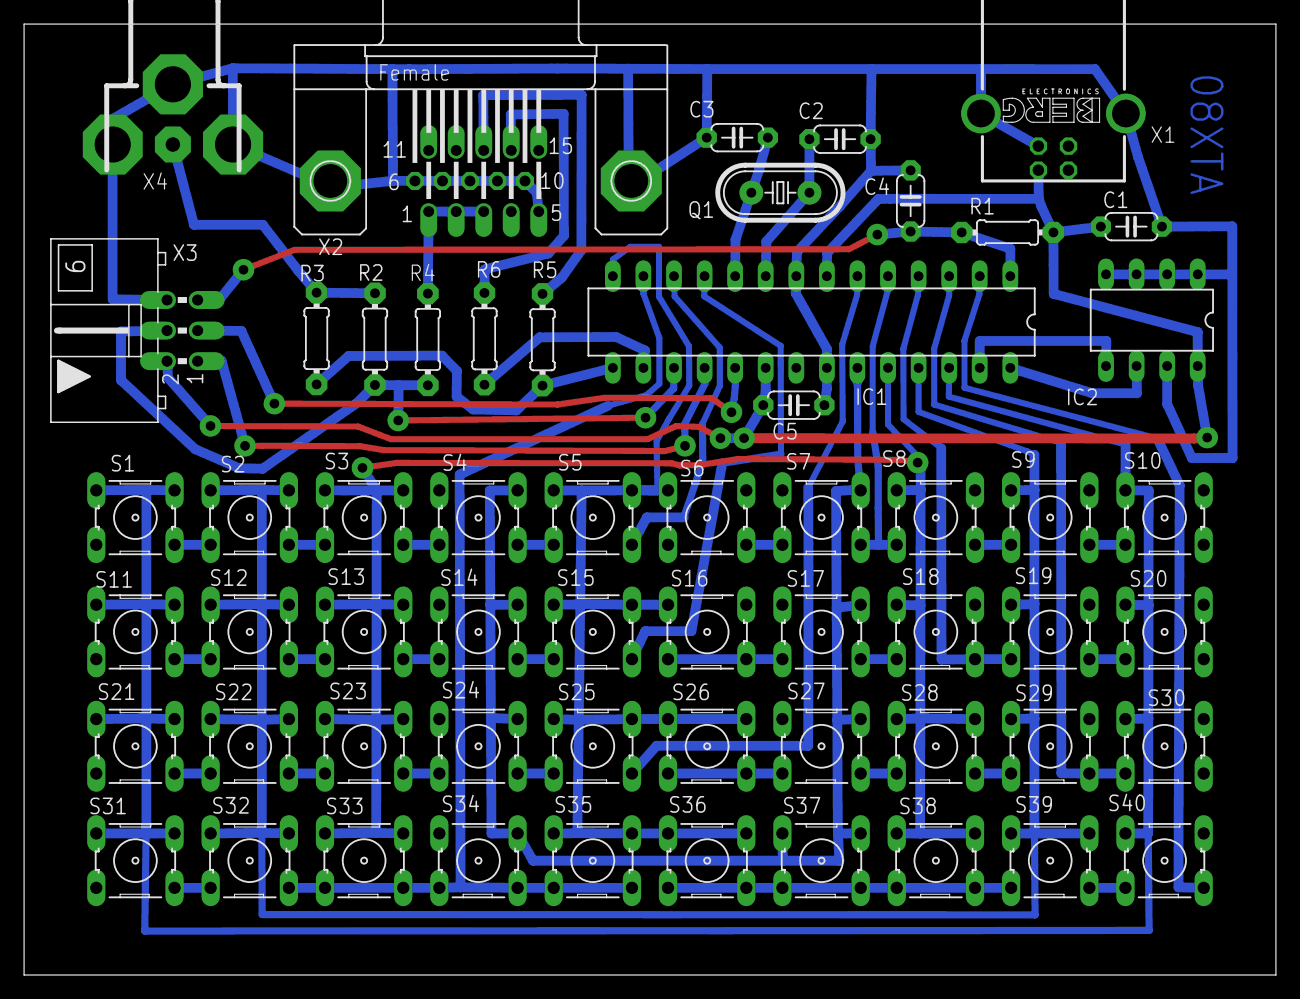
[picture p56: board ATX80.brd from above]

Board: 2 copper layers, 104.0 x 79.0 mm, 58 parts (0 on the bottom side), 29 nets.
